Tazdevil971/project-euler/README.md

# Project Euler
Project euler is an open-source bluetooth head tracker module.

## Folder structure
- `/`: main source code
- `/docs/`: documentation, pin definitions and pinouts.
- `/pcb/`: kicad PCB project
