Tazdevil971/project-euler/pcb/footprints/TL1105AF160Q/TL1105AF160Q.step

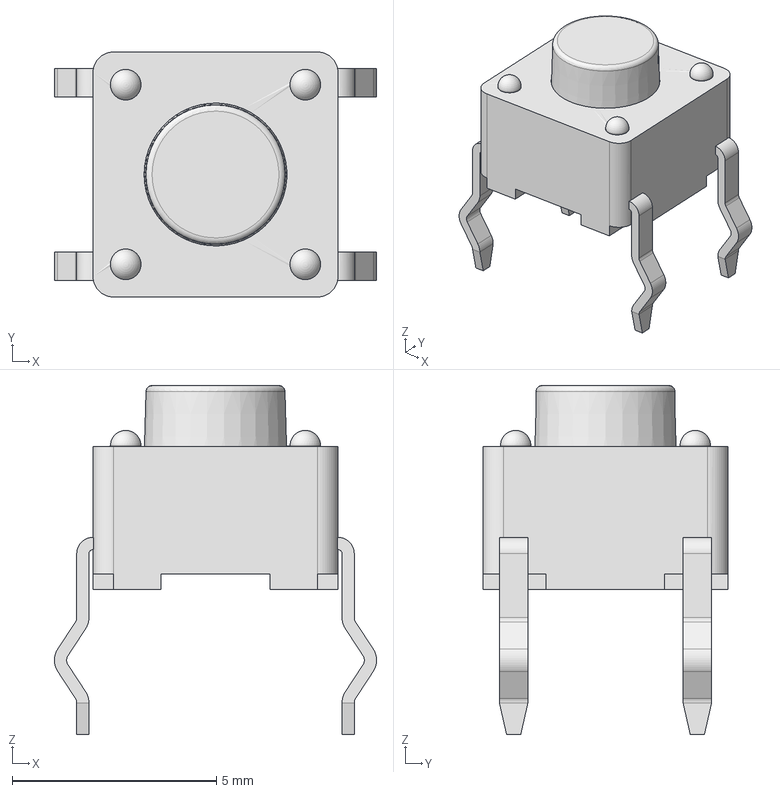
[picture p1: CAD file, 2025-10-28]
pcb/footprints/TL1105AF160Q/TL1105AF160Q.step
7.89 x 6.00 x 8.55 mm
