Tazdevil971/project-euler/pcb/models/B3B-ZR.STEP

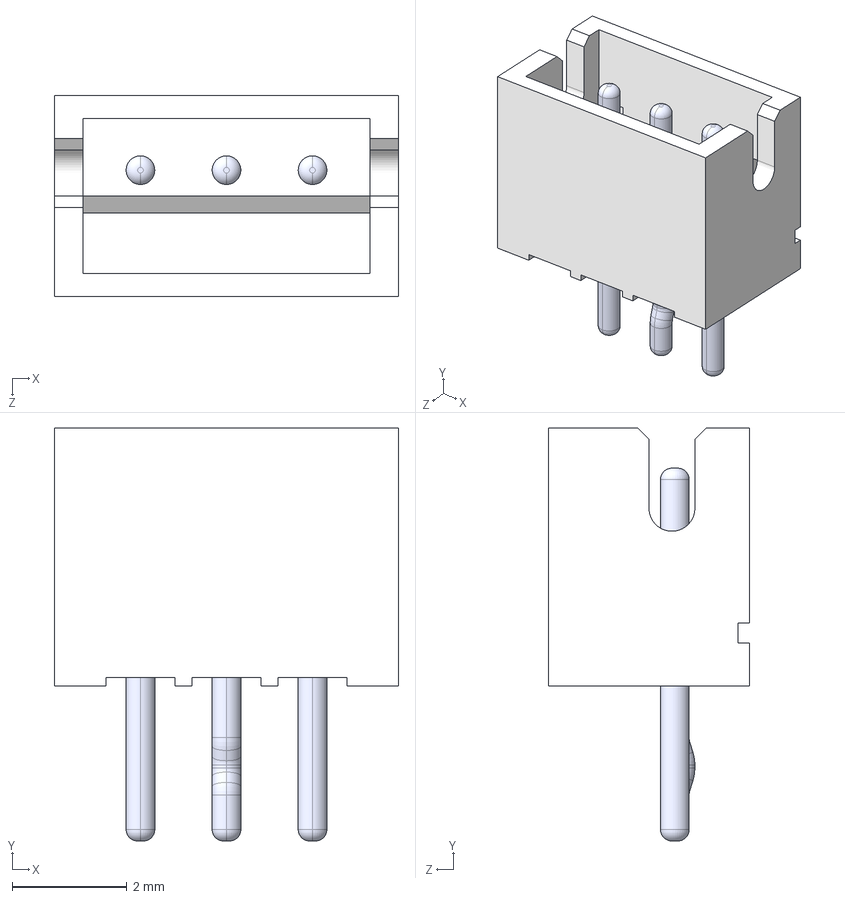
[picture p2: CAD file, 2025-10-28]
pcb/models/B3B-ZR.STEP
6.00 x 7.20 x 3.50 mm
BxB-ZR_3
pin_straight x 2
pin_Bent
