Tazdevil971/project-euler/pcb/project-euler.kicad_pcb

## KiCad design pcb/project-euler.kicad_pcb (2025-11-09)

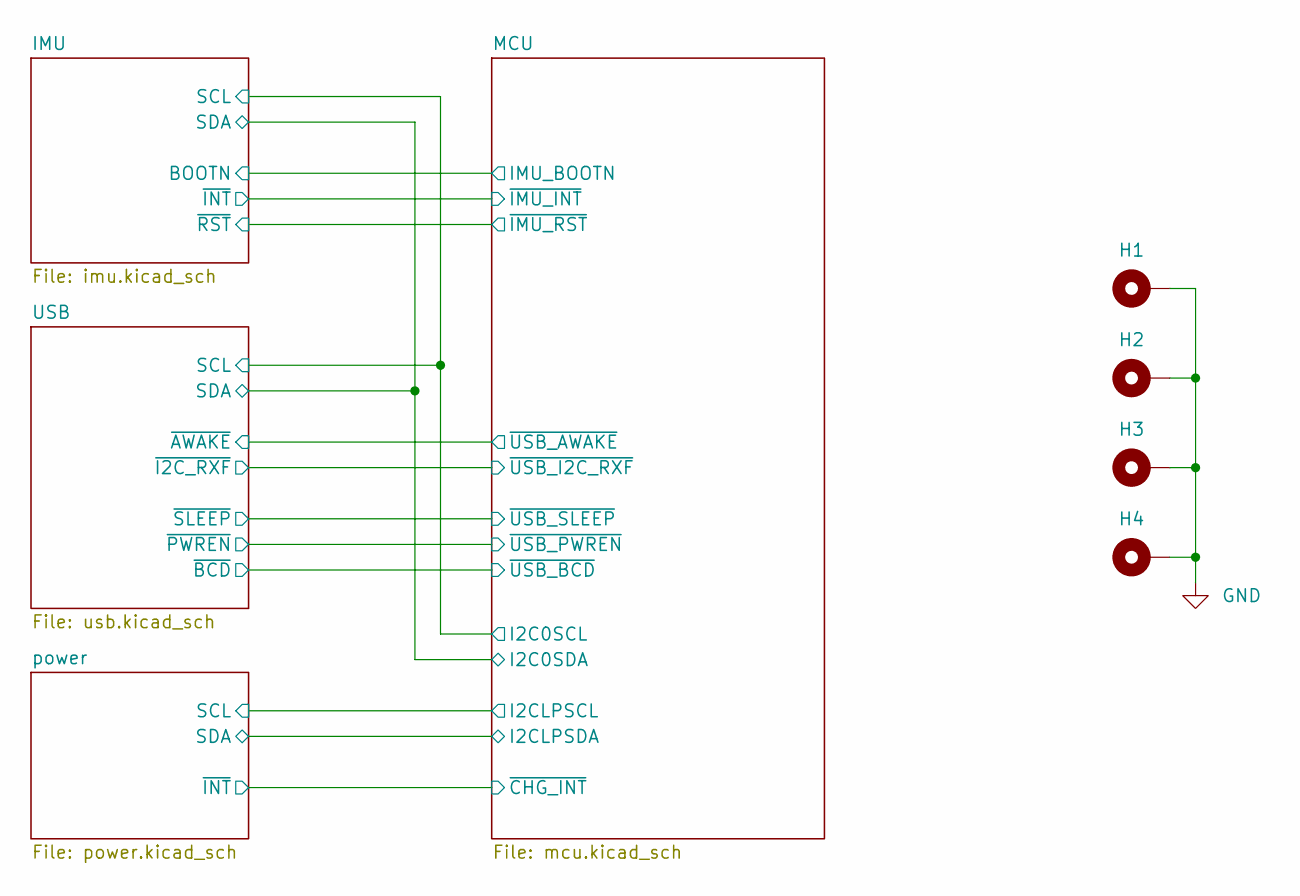
[picture p8: schematic project-euler.kicad_sch]

Parts:
H1, H2, H3, H4: M2; MountingHole_2.7mm_M2.5_Pad

Connections:
GND: H1.1, H2.1, H3.1, H4.1; also elsewhere on the board

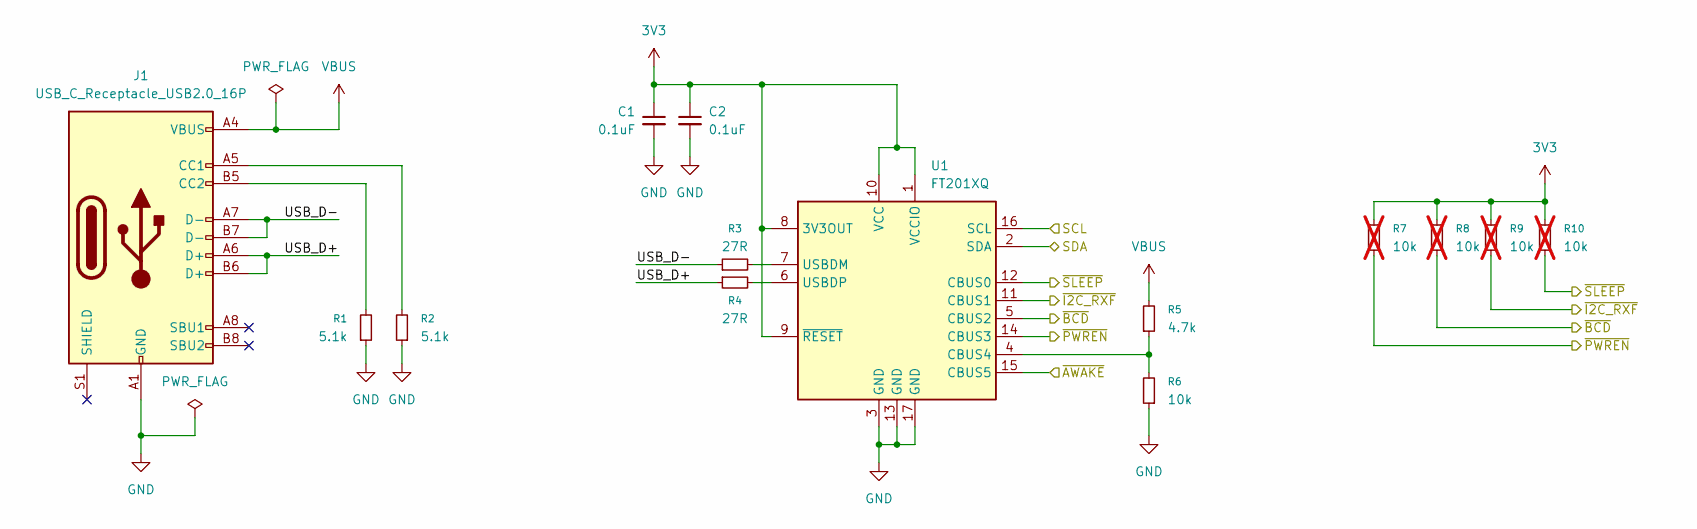
[picture p9: schematic usb.kicad_sch]

Parts:
C1, C2: 0.1uF; C_0603_1608Metric; Part NO GCJ188R71H104KA12D
J1: USB_C_Receptacle_USB2.0_16P; USB_C_Receptacle_GCT_USB4105-xx-A_16P_TopMnt_Horizontal; Part NO USB4105
R1, R2: 5.1k; R_0603_1608Metric_Pad0.98x0.95mm_HandSolder; Part NO CRCW06035K10FKEBC
R3, R4: 27R; R_0603_1608Metric; Part NO CRCW060327R0FKEAC
R5: 4.7k; R_0603_1608Metric; Part NO CRCW06034K70FKEC
R6: 10k; R_0603_1608Metric; Part NO CRCW060310K0FKECC
R7, R8, R9, R10: 10k; R_0603_1608Metric_Pad0.98x0.95mm_HandSolder; Part NO CRCW060310K0FKECC; not fitted
U1: FT201XQ; QFN-16-1EP_4x4mm_P0.65mm_EP2.1x2.1mm; Part NO FT201XQ

Connections:
3V3: C1.1, C2.1, R7.2, R8.2, R9.2, R10.2, U1.1 (VCCIO), U1.8 (3V3OUT), U1.9 (~RESET), U1.10 (VCC); also elsewhere on the board
/IMU/SCL: U1.16 (SCL); also elsewhere on the board
/IMU/SDA: U1.2 (SDA); also elsewhere on the board
/MCU/~USB_AWAKE: U1.15 (CBUS5); also elsewhere on the board
/MCU/~USB_BCD: R8.1, U1.5 (CBUS2); also elsewhere on the board
/MCU/~USB_I2C_RXF: R9.1, U1.11 (CBUS1); also elsewhere on the board
/MCU/~USB_PWREN: R7.1, U1.14 (CBUS3); also elsewhere on the board
/MCU/~USB_SLEEP: R10.1, U1.12 (CBUS0); also elsewhere on the board
/USB/USB_D+: J1.A6 (D+), J1.B6 (D+), R4.1
/USB/USB_D-: J1.A7 (D-), J1.B7 (D-), R3.1
GND: C1.2, C2.2, J1.A1 (GND), J1.A12 (GND), J1.B1 (GND), J1.B12 (GND), R1.1, R2.1, R6.1, U1.3 (GND), U1.13 (GND), U1.17 (GND); also elsewhere on the board
unnamed: J1.A5 (CC1), R2.2
unnamed: J1.B5 (CC2), R1.2
unnamed: R5.1, R6.2, U1.4 (CBUS4)
unnamed: R3.2, U1.7 (USBDM)
unnamed: R4.2, U1.6 (USBDP)
VBUS: J1.A4 (VBUS), J1.A9 (VBUS), J1.B4 (VBUS), J1.B9 (VBUS), R5.2; also elsewhere on the board

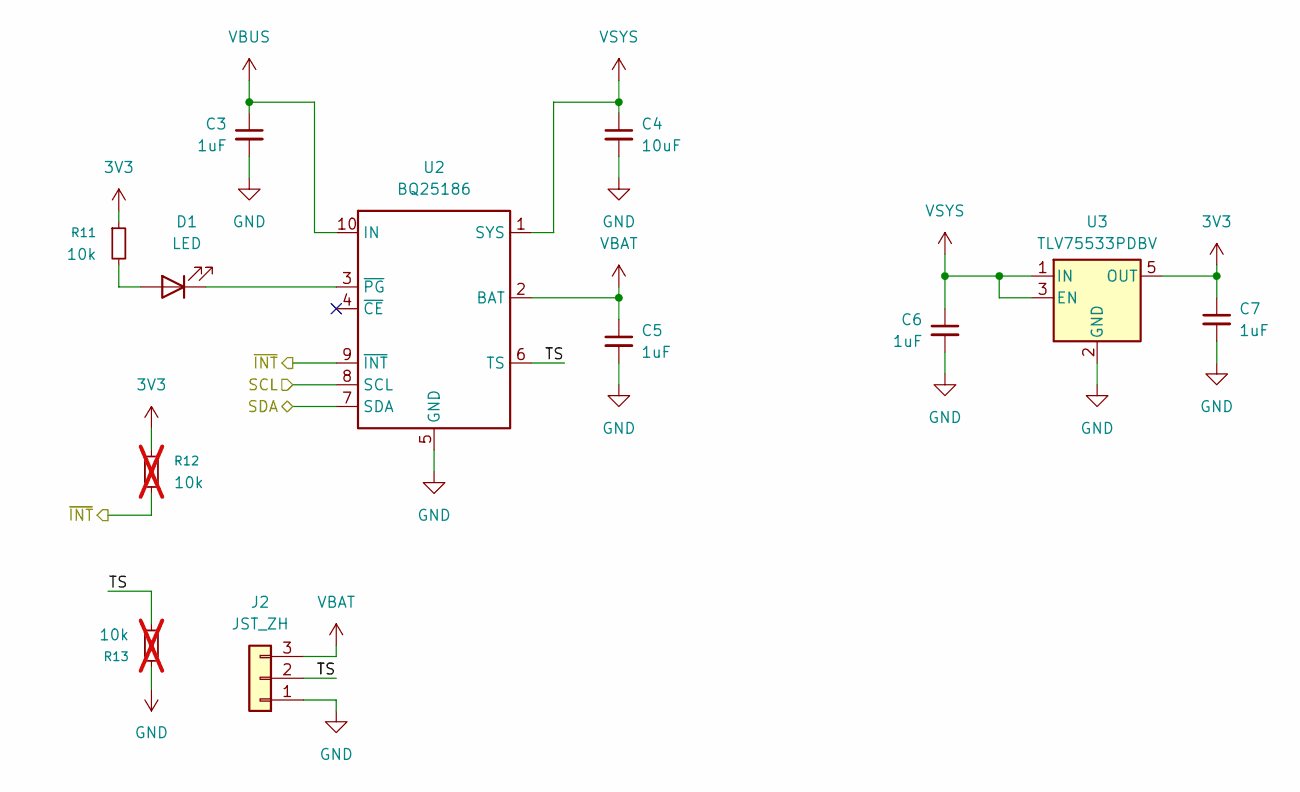
[picture p10: schematic power.kicad_sch]

Parts:
C3, C5, C6, C7: 1uF; C_0603_1608Metric; Part NO GRM188R61A105KA61D
C4: 10uF; C_0603_1608Metric; Part NO GRM188R60G106ME47J
D1: LED; LED_0603_1608Metric_Pad1.05x0.95mm_HandSolder; Part NO 150060GS75000
J2: JST_ZH; JST_ZH_B3B-ZR_1x03_P1.50mm_Vertical; Part NO B3B-ZR
R11: 10k; R_0603_1608Metric; Part NO CRCW060310K0FKECC
R12, R13: 10k; R_0603_1608Metric_Pad0.98x0.95mm_HandSolder; Part NO CRCW060310K0FKECC; not fitted
U2: BQ25186; Texas_DLH0010A_WSON-10-1EP_2.2x2mm_P0.4mm_EP0.9x1.5mm_Therm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; Part NO BQ25186
U3: TLV75533PDBV; SOT-23-5; Part NO TLV75533PDBV

Connections:
3V3: C7.1, R11.1, R12.1, U3.5 (OUT); also elsewhere on the board
/MCU/I2CLPSCL: U2.8 (SCL); also elsewhere on the board
/MCU/I2CLPSDA: U2.7 (SDA); also elsewhere on the board
/MCU/~CHG_INT: R12.2, U2.9 (~INT); also elsewhere on the board
/power/TS: J2.2, R13.2, U2.6 (TS)
GND: C3.2, C4.2, C5.2, C6.2, C7.2, J2.1, R13.1, U2.5 (GND), U2.11 (GND), U3.2 (GND); also elsewhere on the board
unnamed: D1.2 (A), R11.2
unnamed: D1.1 (K), U2.3 (~PG)
VBAT: C5.1, J2.3, U2.2 (BAT); also elsewhere on the board
VBUS: C3.1, U2.10 (IN); also elsewhere on the board
VSYS: C4.1, C6.1, U2.1 (SYS), U3.1 (IN), U3.3 (EN)

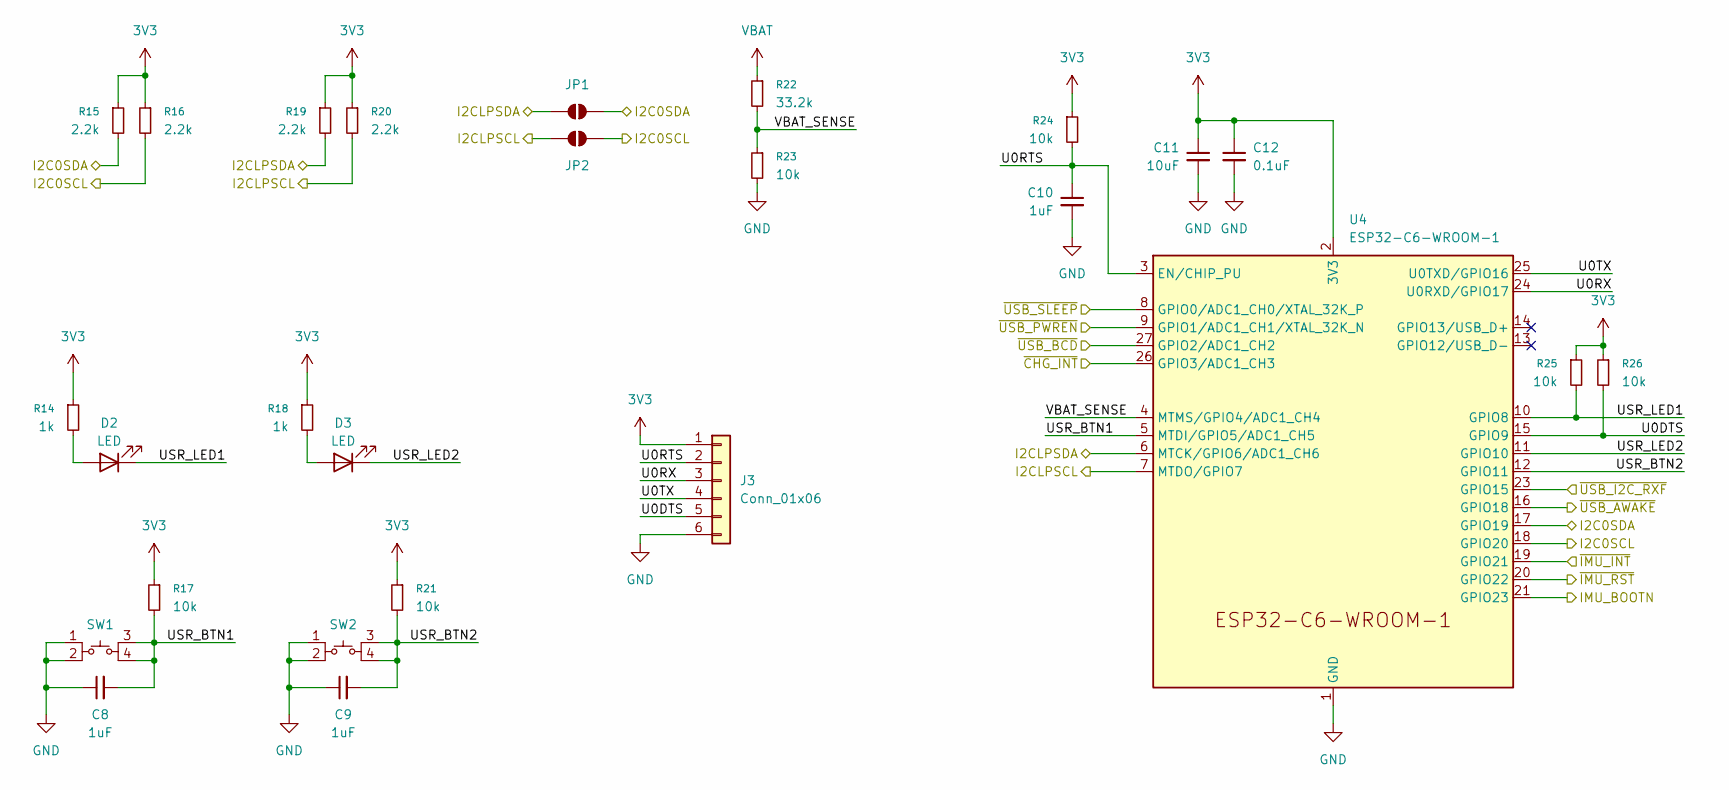
[picture p11: schematic mcu.kicad_sch]

Parts:
C8, C9, C10: 1uF; C_0603_1608Metric; Part NO GRM188R61A105KA61D
C11: 10uF; C_0603_1608Metric; Part NO GRM188R60G106ME47J
C12: 0.1uF; C_0603_1608Metric; Part NO GCJ188R71H104KA12D
D2, D3: LED; LED_0603_1608Metric_Pad1.05x0.95mm_HandSolder; Part NO 150060GS75000
J3: Conn_01x06; PinHeader_2x03_P2.54mm_Vertical
JP1, JP2: SolderJumper_2_Open; SolderJumper-2_P1.3mm_Open_Pad1.0x1.5mm
R14, R18: 1k; R_0603_1608Metric; Part NO CRCW06031K00FKECC
R15, R16: 2.2k; R_0603_1608Metric; Part NO CRCW06032K20FKEAC
R17, R21, R23, R24, R25, R26: 10k; R_0603_1608Metric; Part NO CRCW060310K0FKECC
R19, R20: 2.2k; R_0603_1608Metric_Pad0.98x0.95mm_HandSolder; Part NO CRCW06032K20FKEAC
R22: 33.2k; R_0603_1608Metric; Part NO CRCW060333K2FKEAC
SW1, SW2: SW_TL1105AF160Q; Part NO TL1105AF160Q
U4: ESP32-C6-WROOM-1; Part NO ESP32-C6-WROOM-1

Connections:
3V3: C11.1, C12.1, J3.1, R14.1, R15.1, R16.1, R17.1, R18.1, R19.1, R20.1, R21.1, R24.1, R25.1, R26.1, U4.2 (3V3); also elsewhere on the board
/IMU/BOOTN: U4.21 (GPIO23); also elsewhere on the board
/IMU/SCL: JP2.2 (B), R16.2, U4.18 (GPIO20); also elsewhere on the board
/IMU/SDA: JP1.2 (B), R15.2, U4.17 (GPIO19); also elsewhere on the board
/IMU/~INT: U4.19 (GPIO21); also elsewhere on the board
/IMU/~RST: U4.20 (GPIO22); also elsewhere on the board
/MCU/I2CLPSCL: JP2.1 (A), R20.2, U4.7 (MTDO/GPIO7); also elsewhere on the board
/MCU/I2CLPSDA: JP1.1 (A), R19.2, U4.6 (MTCK/GPIO6/ADC1_CH6); also elsewhere on the board
/MCU/U0DTS: J3.5, R26.2, U4.15 (GPIO9)
/MCU/U0RTS: C10.1, J3.2, R24.2, U4.3 (EN/CHIP_PU)
/MCU/U0RX: J3.3, U4.24 (U0RXD/GPIO17)
/MCU/U0TX: J3.4, U4.25 (U0TXD/GPIO16)
/MCU/USR_BTN1: C8.2, R17.2, SW1.3, SW1.4, U4.5 (MTDI/GPIO5/ADC1_CH5)
/MCU/USR_BTN2: C9.2, R21.2, SW2.3, SW2.4, U4.12 (GPIO11)
/MCU/USR_LED1: D2.1 (K), R25.2, U4.10 (GPIO8)
/MCU/USR_LED2: D3.1 (K), U4.11 (GPIO10)
/MCU/VBAT_SENSE: R22.2, R23.1, U4.4 (MTMS/GPIO4/ADC1_CH4)
/MCU/~CHG_INT: U4.26 (GPIO3/ADC1_CH3); also elsewhere on the board
/MCU/~USB_AWAKE: U4.16 (GPIO18); also elsewhere on the board
/MCU/~USB_BCD: U4.27 (GPIO2/ADC1_CH2); also elsewhere on the board
/MCU/~USB_I2C_RXF: U4.23 (GPIO15); also elsewhere on the board
/MCU/~USB_PWREN: U4.9 (GPIO1/ADC1_CH1/XTAL_32K_N); also elsewhere on the board
/MCU/~USB_SLEEP: U4.8 (GPIO0/ADC1_CH0/XTAL_32K_P); also elsewhere on the board
GND: C8.1, C9.1, C10.2, C11.2, C12.2, J3.6, R23.2, SW1.1, SW1.2, SW2.1, SW2.2, U4.1 (GND), U4.28 (GND), U4.29 (GND); also elsewhere on the board
unnamed: D2.2 (A), R14.2
unnamed: D3.2 (A), R18.2
VBAT: R22.1; also elsewhere on the board

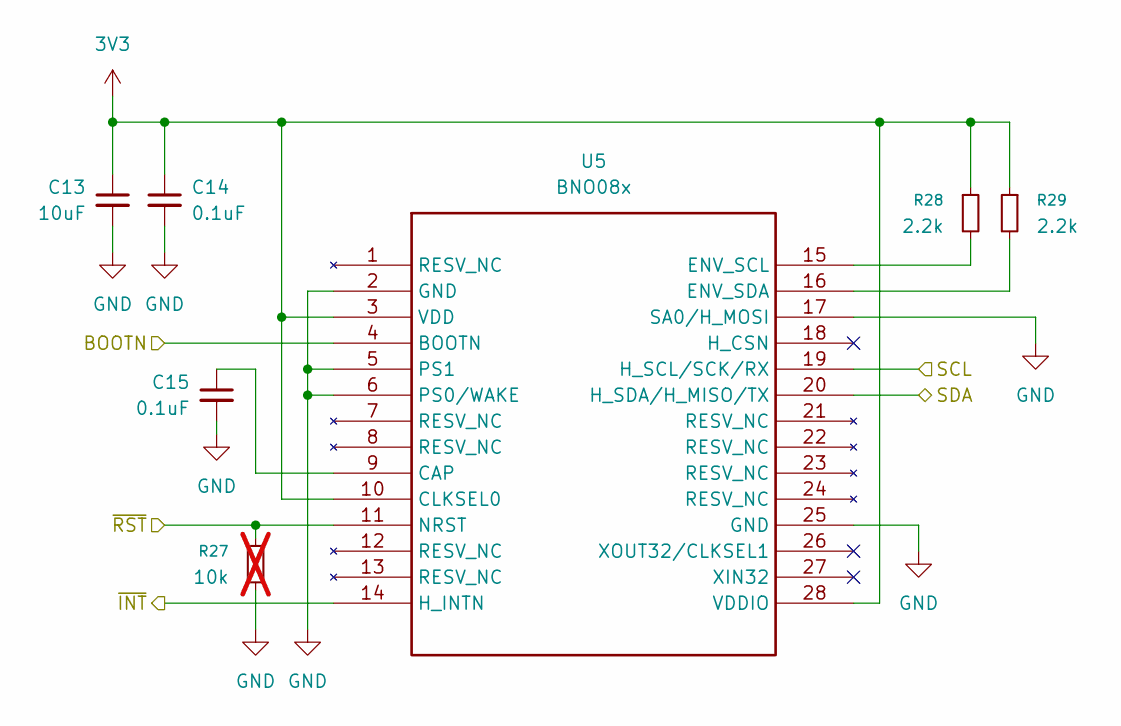
[picture p12: schematic imu.kicad_sch]

Parts:
C13: 10uF; C_0603_1608Metric; Part NO GRM188R60G106ME47J
C14, C15: 0.1uF; C_0603_1608Metric; Part NO GCJ188R71H104KA12D
R27: 10k; R_0603_1608Metric; Part NO CRCW060310K0FKECC; not fitted
R28, R29: 2.2k; R_0603_1608Metric; Part NO CRCW06032K20FKEAC
U5: BNO08x; LGA-28_5.2x3.8mm_P0.5mm; Part NO BNO086

Connections:
3V3: C13.1, C14.1, R28.1, R29.1, U5.3 (VDD), U5.10 (CLKSEL0), U5.28 (VDDIO); also elsewhere on the board
/IMU/BOOTN: U5.4 (BOOTN); also elsewhere on the board
/IMU/SCL: U5.19 (H_SCL/SCK/RX); also elsewhere on the board
/IMU/SDA: U5.20 (H_SDA/H_MISO/TX); also elsewhere on the board
/IMU/~INT: U5.14 (H_INTN); also elsewhere on the board
/IMU/~RST: R27.1, U5.11 (NRST); also elsewhere on the board
GND: C13.2, C14.2, C15.2, R27.2, U5.2 (GND), U5.5 (PS1), U5.6 (PS0/WAKE), U5.17 (SA0/H_MOSI), U5.25 (GND); also elsewhere on the board
unnamed: C15.1, U5.9 (CAP)
unnamed: R28.2, U5.15 (ENV_SCL)
unnamed: R29.2, U5.16 (ENV_SDA)

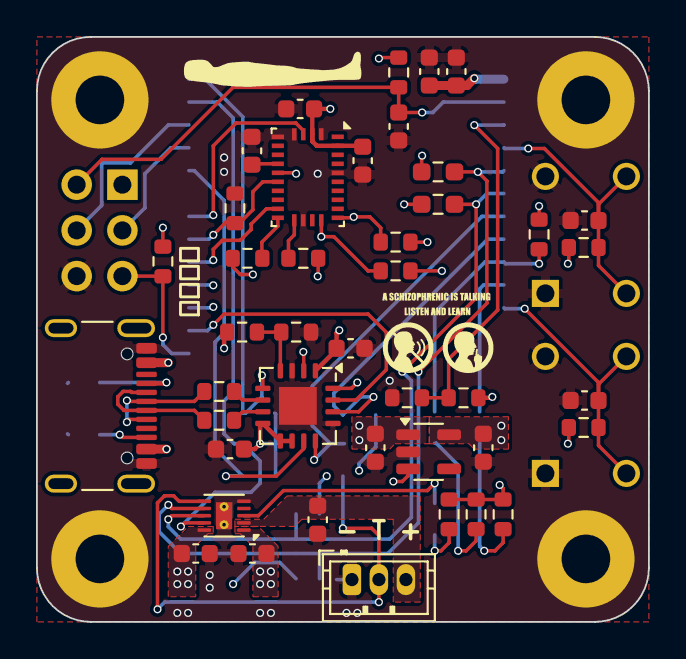
[picture p13: board project-euler.kicad_pcb from above]

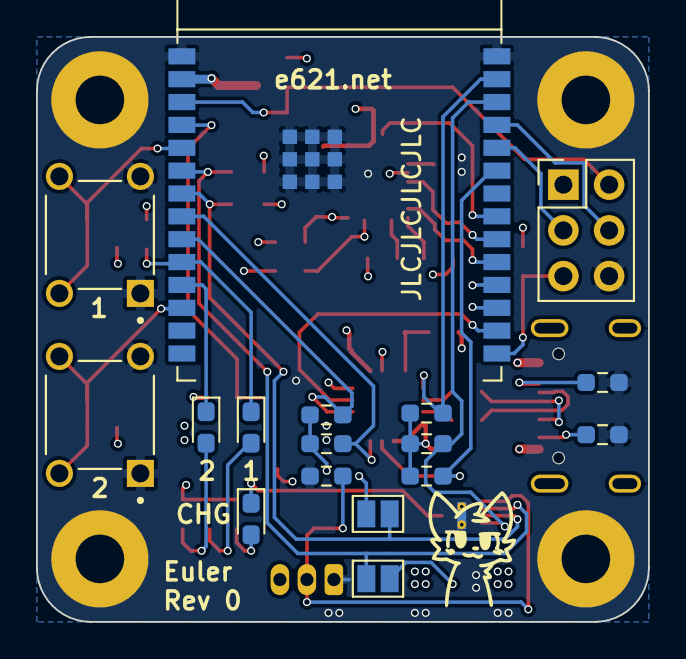
[picture p14: board project-euler.kicad_pcb from below]

Board: 4 copper layers, 34.0 x 32.5 mm, 63 parts (17 on the bottom side), 42 nets.
