Tazdevil971/project-euler/(commit log)

2025-11-09 [firmware/pcb] Initial firmware upload + fixed mistake in PCB + added errata documentation
    [imu.kicad_sch, mcu.kicad_sch, project-euler.kicad_pcb, project-euler.kicad_sch]
2025-11-14 [firmware] Initial Bno08x driver taking shape
